reedstrm/dehumidifier/8266_proto/8266_proto.kicad_pcb

## KiCad design 8266_proto/8266_proto.kicad_pcb (2026-02-07)

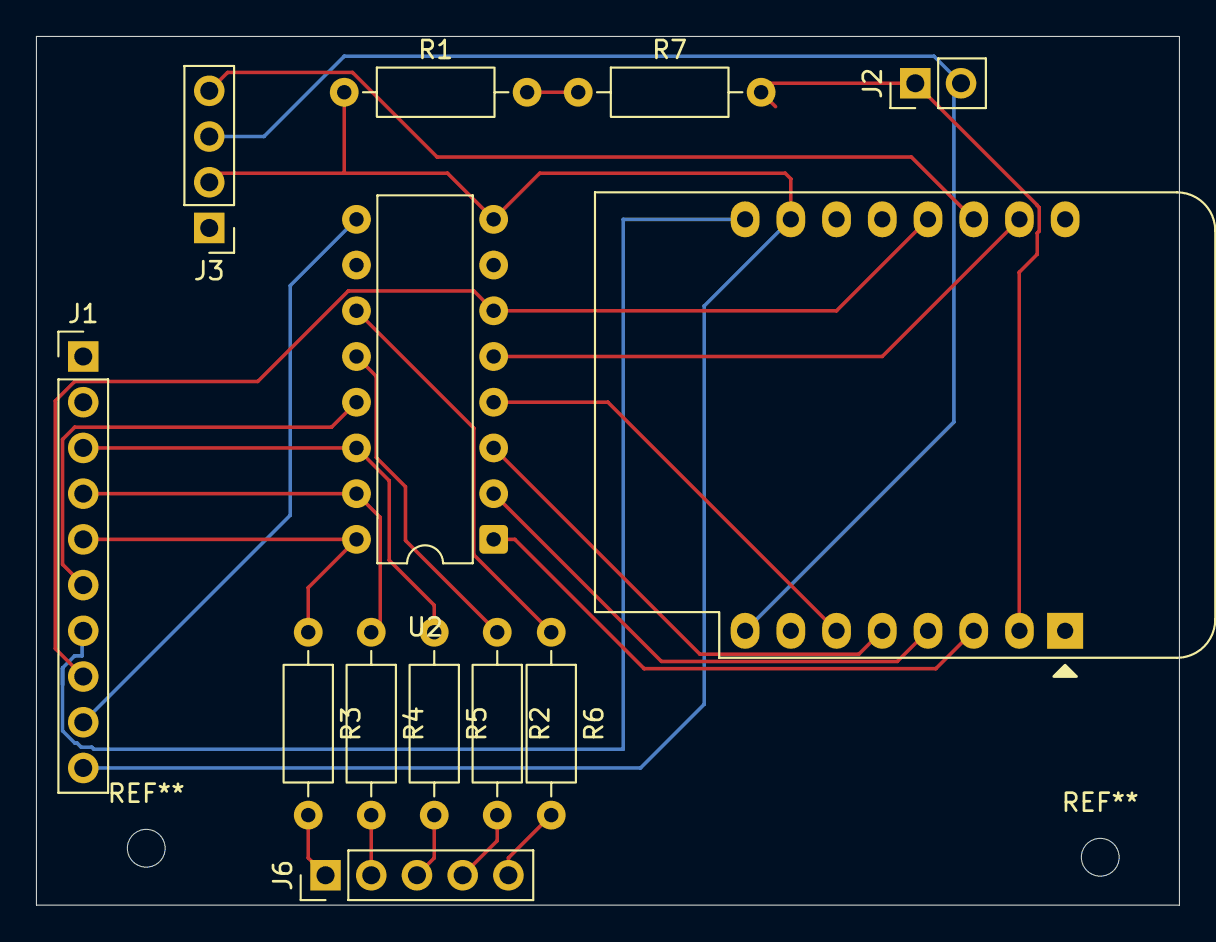
[picture p1: board 8266_proto.kicad_pcb from above]

Board: 2 copper layers, 63.5 x 48.3 mm, 13 parts (0 on the bottom side), 24 nets.

Parts:
J1: To Power and Relay Board; PinHeader_1x10_P2.54mm_Vertical
J2: EVAP_TEMP; PinHeader_1x02_P2.54mm_Vertical
J3: INTAKE_HUM_TEMP; PinHeader_1x04_P2.54mm_Vertical
J6: LEDs; PinHeader_1x05_P2.54mm_Vertical
R1, R7: 10k; R_Axial_DIN0207_L6.3mm_D2.5mm_P10.16mm_Horizontal
R2, R3, R4, R5, R6: 1K; R_Axial_DIN0207_L6.3mm_D2.5mm_P10.16mm_Horizontal
U1: WEMOS_D1_mini; WEMOS_D1_mini_light
U2: ULN2003A; DIP-16_W7.62mm

Connections:
+3.3V: J2.2, J3.3, U1.8 (3V3)
+5V: J1.7, U1.9 (5V)
/12V: J1.9, U2.9 (COM)
/Bucket Full: J6.5, R6.2
/COMP: J1.6, U2.13 (O4)
/COMP_CMD: U1.6 (MOSI/D7), U2.4 (I4)
/Dehum Req: J6.4, R2.2
/FAN_H: J1.5, R3.1, U2.16 (O1)
/FAN_H_CMD: U1.3 (D0), U2.1 (I1)
/FAN_L: J1.3, R5.1, U2.14 (O3)
/FAN_L_CMD: U1.5 (MISO/D6), U2.3 (I3)
/FAN_M: J1.4, R4.1, U2.15 (O2)
/FAN_M_CMD: U1.4 (SCK/D5), U2.2 (I2)
/FL1: J1.8, U1.13 (SDA/D2), U2.6 (I6)
/Fan High: J6.1, R3.2
/Fan Low: J6.3, R5.2
/Fan Medium: J6.2, R4.2
/HUM_DATA: J3.4, U1.14 (SCL/D1)
/NTC_R: J2.1, R7.2, U1.2 (A0)
GND: J1.10, J3.2, R1.1, U1.10 (GND), U2.8 (GND)
unnamed: R1.2, R7.1
unnamed: U1.15 (RX), U2.5 (I5)
unnamed: R2.1, U2.12 (O5)
unnamed: R6.1, U2.11 (O6)
