reedstrm/dehumidifier/(commit log)

2026-01-10 first cut
2026-01-10 make it compile. Set the proper pins. Calibrate NTC
2026-01-12 less fan chatter. Lockout countdown status
2026-01-12 add two switches and two LEDs
2026-02-03 fixup LED outputs
2026-02-03 remove input switches. Move some outputs to as-built
2026-02-07 board images and chip docs
2026-02-07 kicad schematic and board
    [8266_proto.kicad_pcb, 8266_proto.kicad_sch]
2026-02-07 Add fan/compressor safety interlocks (#1)
    * Add fan/compressor safety interlocks
    * Refine fan interlock behavior
    * Route compressor fan start through apply_fan_mode
2026-02-07 Remove KiCad backups (#2)
2026-02-07 Clarify idle bucket full state (#3)
